iwatake2222/DigitalCamera_STM32/01_doc/pic_breakout.jpg

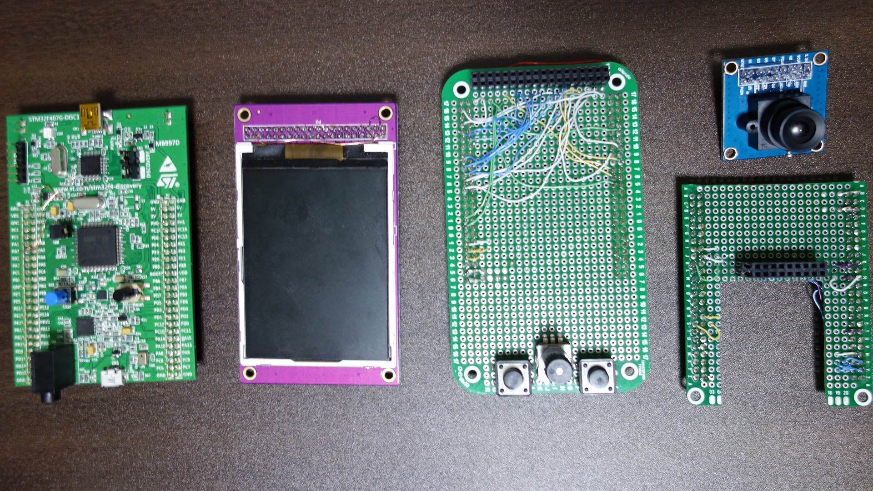
01_doc/pic_breakout.jpg
