iwatake2222/DigitalCamera_STM32/01_doc/pic_top.jpg

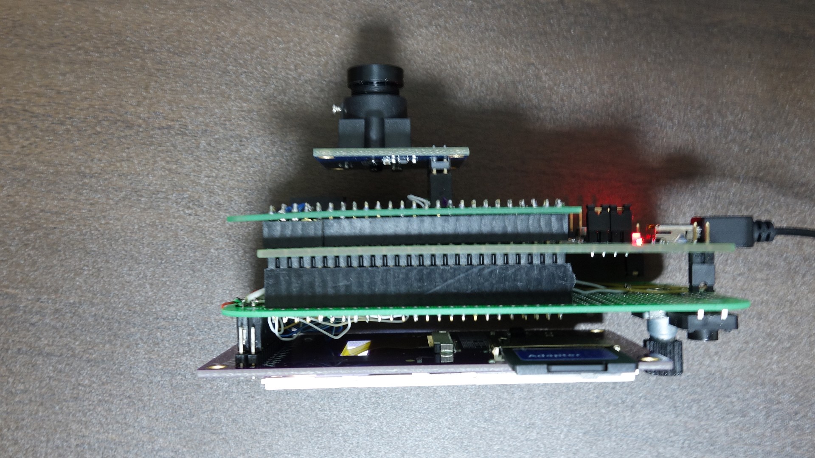
01_doc/pic_top.jpg
