iwatake2222/DigitalCamera_STM32/(threads)

Thread 1 (2017-11-02):

Great project but I can't get SCCB to work!!

g8ecj, 2017-11-02:
Call stack goes:
ov7670_init
ov7670_write
HAL_I2C_Mem_Write
I2C_RequestMemoryWrite
I2C_WaitOnMasterAddressFlagUntilTimeout <-- fails with timeout

Logic analyser says there is a NACK instead of ACK (as expected) but how do I ignore this condition? Only the address part of the transaction is completed.

take-iwiw, 2017-11-02:
Thank you for the report with detailed information. I actually had an similar issue with SCCB read operaion, but write operation was okay in my environment. So, there might be something depending on device.
 My workaround for read operation is to use HAL_I2C_Master_Transmit instead of HAL_I2C_Mem_Read and communicate with the sensor byte by byte, so that STM32 doesn't care ack/nack.
I think the same solution will work for write operation. I will give it a try next week. (I'm on vacation this week, sorry!)

BTW, do you supply MCLK to the sensor? (I use MCO in my project). Otherwise, the sensor doesn't work at all, then your analyser might consider it as NACK. (You said the address part was working, so I think it must be okay, though.)

g8ecj, 2017-11-02:
Making progress - I had the PWRDN signal the wrong way up which caused the camera to be asleep all the time.
SCCB now works correctly, just trying to get sync to work (I'm not using all your code, just the parts I feel are necessary to prove the camera works OK).
You use HSync from the camera, how do you define the start of frame? (I get a diagonal pattern with no recognisable picture).

take-iwiw, 2017-11-06:
That's good. SCCB communication problem was just because of wrong PWRDN signal.
You can refer br_lesson branch (https://github.com/take-iwiw/DigitalCamera_STM32/tree/br_lesson). This is a simple implementation of ov7670 driver and live view function.
When AGC enabled, fps may vary depending on brightness.
I recommend you take a look at OV7670 driver on Linux, and OV7670 Implementation Guide (not a datasheet). They are useful.

ShikharJ, 2020-09-19:
@iwatake2222 I'm facing the same issue as described above. However, in my case, both the ` HAL_I2C_Mem_Write` and `HAL_I2C_Master_Transmit` are failing while reaching the `I2C_WaitOnMasterAddressFlagUntilTimeout` One thing to note here is that I'm not getting a timeout failure, rather a acknowledge failure in the below snippet:
```
while (__HAL_I2C_GET_FLAG(hi2c, Flag) == RESET)
  {
    if (__HAL_I2C_GET_FLAG(hi2c, I2C_FLAG_AF) == SET) <--- Fulfills this if condition
    {
      /* Generate Stop */
      SET_BIT(hi2c->Instance->CR1, I2C_CR1_STOP);

      /* Clear AF Flag */
      __HAL_I2C_CLEAR_FLAG(hi2c, I2C_FLAG_AF);

      hi2c->PreviousState       = I2C_STATE_NONE;
      hi2c->State               = HAL_I2C_STATE_READY;
      hi2c->Mode                = HAL_I2C_MODE_NONE;
      hi2c->ErrorCode           |= HAL_I2C_ERROR_AF;

      /* Process Unlocked */
      __HAL_UNLOCK(hi2c);

      return HAL_ERROR;  <----- Fails here
    }
....
}
```

Closed 2017-12-28.

Thread 3 (2020-10-14):

Can't Get The Camera To Work

ShikharJ, 2020-10-14:
I'm facing the same issue as described [here](#1). However, in my case, both the ` HAL_I2C_Mem_Write` and `HAL_I2C_Master_Transmit` are failing while reaching the `I2C_WaitOnMasterAddressFlagUntilTimeout` One thing to note here is that I'm not getting a timeout failure, rather a acknowledge failure in the below snippet:
```
while (__HAL_I2C_GET_FLAG(hi2c, Flag) == RESET)
  {
    if (__HAL_I2C_GET_FLAG(hi2c, I2C_FLAG_AF) == SET) <--- Fulfills this if condition
    {
      /* Generate Stop */
      SET_BIT(hi2c->Instance->CR1, I2C_CR1_STOP);

      /* Clear AF Flag */
      __HAL_I2C_CLEAR_FLAG(hi2c, I2C_FLAG_AF);

      hi2c->PreviousState       = I2C_STATE_NONE;
      hi2c->State               = HAL_I2C_STATE_READY;
      hi2c->Mode                = HAL_I2C_MODE_NONE;
      hi2c->ErrorCode           |= HAL_I2C_ERROR_AF;

      /* Process Unlocked */
      __HAL_UNLOCK(hi2c);

      return HAL_ERROR;  <----- Fails here
    }
....
}
```
Any help regarding the same will be very appreciated.

iwatake2222, 2020-10-19:
Hmm, I have no idea. Sorry.

Closed 2020-10-24.

Thread 4 (2022-03-29):

Excule me， I want to ask you a question

lhyyyy-x, 2022-03-29:
When I was studying your project,encountered a problem that I didn't quite understand.

This is log:
[LV_CTRL:141] input: 1 0
[LV_CTRL:319] Single Capture Start
[LV_CTRL:326] create IMG005.JPG
Output file write error --- out of disk space?
Improper call to JPEG library in state 0

I hope to receive your reply.
Thank you!

iwatake2222, 2022-03-30:
Thank you for trying my project, but I did it more than 5 years ago. So, I don't remember it and can't really help you. Sorry.
The only thing that can come up with is SD card. Your SD card may be unrecognized. If you use SD card with large capacity, I suggest using 8GB SD card.

lhyyyy-x, 2022-04-05:
Thank you very much for replying to me in your busy schedule！
But Iwant to ask a question，My SD card can be used on other development boards, but it doesn't seem to mount here. Do you have any other special operations.
Or can you provide a contact information? I'd like to ask you further.
Thank you very much for your help！
@iwatake2222

iwatake2222, 2022-04-09:
hmm, I can't think of any other cause.
