iwatake2222/DigitalCamera_STM32/DigitalCamera_STM32.ioc

Mcu.UserName=STM32F407VGTx
PA0-WKUP.Signal=S_TIM5_CH1
PA1.Signal=S_TIM5_CH2
PA10.GPIO_Label=OTG_FS_ID
PA10.Signal=USB_OTG_FS_ID
PA11.GPIO_Label=OTG_FS_DM
PA11.Signal=USB_OTG_FS_DM
PA12.GPIO_Label=OTG_FS_DP
PA12.Signal=USB_OTG_FS_DP
PA13.GPIO_Label=SWDIO
PA13.Signal=SYS_JTMS-SWDIO
PA14.GPIO_Label=SWCLK
PA14.Signal=SYS_JTCK-SWCLK
PA15.GPIO_Label=SD_CS
PA15.Signal=GPIO_Output
PA2.Signal=USART2_TX
PA3.Signal=USART2_RX
PA4.Signal=DCMI_HSYNC
PA5.Signal=SPI1_SCK
PA6.Signal=DCMI_PIXCK
PA7.Signal=SPI1_MOSI
PA8.Signal=RCC_MCO_1
PA9.GPIO_Label=VBUS_FS
PA9.Signal=USB_OTG_FS_VBUS
PB10.Signal=I2C2_SCL
PB11.Signal=I2C2_SDA
PB2.GPIO_Label=BOOT1
PB2.Signal=GPIO_Input
PB3.GPIO_Label=SWO
PB3.Signal=SYS_JTDO-SWO
PB4.Signal=SPI1_MISO
PB6.Signal=DCMI_D5
PB7.Signal=DCMI_VSYNC
PB8.Signal=DCMI_D6
PB9.Signal=DCMI_D7
PC0.GPIO_Label=OTG_FS_PowerSwitchOn
PC0.Signal=GPIO_Output
PC1.GPIO_Label=BTN_CAP
PC1.Signal=GPIO_Input
PC11.Signal=DCMI_D4
PC14-OSC32_IN.GPIO_Label=PC14-OSC32_IN
PC14-OSC32_IN.Signal=RCC_OSC32_IN
PC15-OSC32_OUT.GPIO_Label=PC15-OSC32_OUT
PC15-OSC32_OUT.Signal=RCC_OSC32_OUT
PC2.GPIO_Label=BTN_MODE
PC2.Signal=GPIO_Input
PC3.GPIO_Label=BTN_OTHER0
PC3.Signal=GPIO_Input
PC5.GPIO_Label=CAMERA_RESET
PC5.Signal=GPIO_Output
PC6.Signal=DCMI_D0
PC7.Signal=DCMI_D1
PC8.Signal=DCMI_D2
PC9.Signal=DCMI_D3
PD0.Signal=FSMC_D2
PD1.Signal=FSMC_D3
PD10.Signal=FSMC_D15
PD11.Signal=FSMC_A16
PD12.GPIO_Label=LD4 [Green Led]
PD12.Signal=GPIO_Output
PD13.GPIO_Label=LD3 [Orange Led]
PD13.Signal=GPIO_Output
PD14.Signal=FSMC_D0
PD15.Signal=FSMC_D1
PD4.Signal=FSMC_NOE
PD5.Signal=FSMC_NWE
PD7.Signal=FSMC_NE1
PD8.Signal=FSMC_D13
PD9.Signal=FSMC_D14
PE10.Signal=FSMC_D7
PE11.Signal=FSMC_D8
PE12.Signal=FSMC_D9
PE13.Signal=FSMC_D10
PE14.Signal=FSMC_D11
PE15.Signal=FSMC_D12
PE3.GPIO_Label=CS_I2C/SPI [LIS302DL_CS_I2C/SPI]
PE3.Signal=GPIO_Output
PE7.Signal=FSMC_D4
PE8.Signal=FSMC_D5
PE9.Signal=FSMC_D6
PH0-OSC_IN.GPIO_Label=PH0-OSC_IN
PH0-OSC_IN.Signal=RCC_OSC_IN
PH1-OSC_OUT.GPIO_Label=PH1-OSC_OUT
PH1-OSC_OUT.Signal=RCC_OSC_OUT
