iwatake2222/DigitalCamera_STM32/Src/driver/ov7670/ov7670.h

/*
 * ov7670.h
 *
 *  Created on: 2017/08/25
 *      Author: take-iwiw
 */

#ifndef OV7670_OV7670_H_
#define OV7670_OV7670_H_

#define OV7670_MODE_QVGA_RGB565 0
#define OV7670_MODE_QVGA_YUV    1

#define OV7670_CAP_CONTINUOUS   0
#define OV7670_CAP_SINGLE_FRAME 1

RET ov7670_init(DCMI_HandleTypeDef *p_hdcmi, DMA_HandleTypeDef *p_hdma_dcmi, I2C_HandleTypeDef *p_hi2c);
RET ov7670_config(uint32_t mode);
RET ov7670_startCap(uint32_t capMode, uint32_t destAddress);
RET ov7670_stopCap();
void ov7670_registerCallback(void (*cbHsync)(uint32_t h), void (*cbVsync)(uint32_t v));

#endif /* OV7670_OV7670_H_ */
