iwatake2222/DigitalCamera_STM32/(commit log)

2017-08-25 cloned from Camera_STM32_Hal repository, where liveview function without RTOS is implemented
    [DigitalCamera_STM32 Run.cfg]
2017-08-27 implemented to use camera reset pin
2017-08-27 disabled unused on-board LIS302DL. This is very important. without this, signal from LIS302 and camera interfere with each other when I move the board
    [DigitalCamera_STM32.ioc, main.c, user_diskio.c]
2017-08-30 The first complete version fixed ov7670 register setting. fixed fsmc timing for read operation
    [DigitalCamera_STM32.ioc, applicationSettings.h, liveviewCtrl.c, main.c, ov7670Reg.h, playbackCtrl.c]
2017-08-30 fixed decode image scaling calculation
    [playbackCtrl.c]
